humble-learner006/Robomaster-Track-AA-Training-Robot/02-firmware/README.md

Sentry Chassis on Event OS

Debug Log:
1.

Version Control:
1. 2024-05-14 张树涵 Initial version
2. 2024-09-08 张树涵 Remove most unused processes
