humble-learner006/Robomaster-Track-AA-Training-Robot/02-firmware/SEML/Doc/Pictures/DSP/1690799671915.jpg

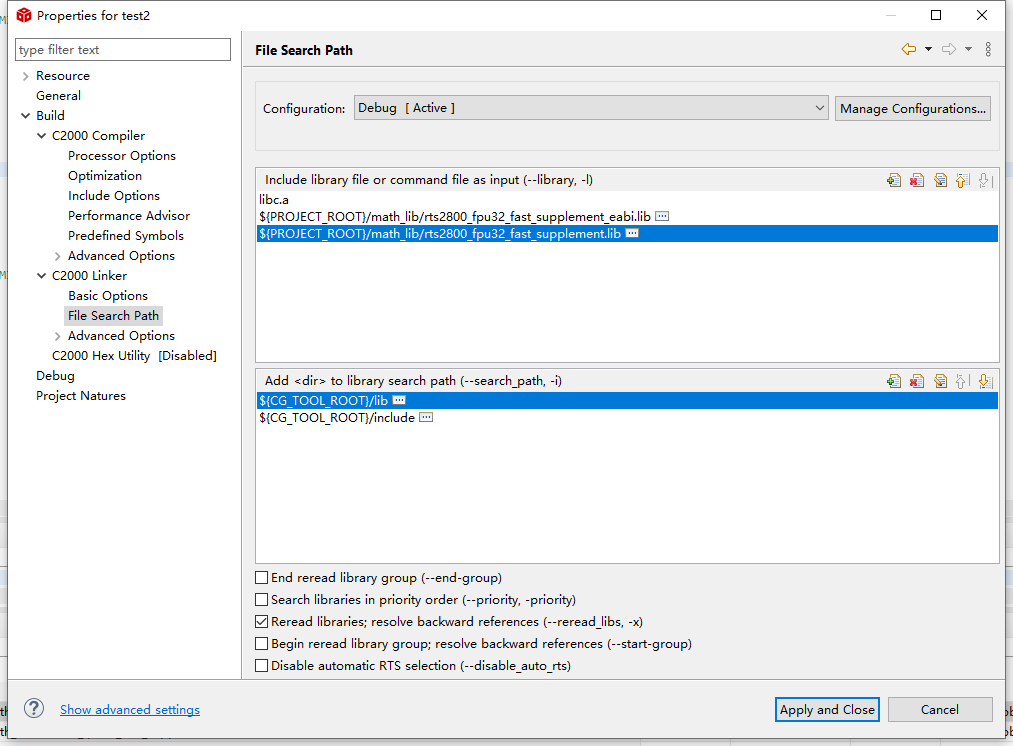
02-firmware/SEML/Doc/Pictures/DSP/1690799671915.jpg
