humble-learner006/Robomaster-Track-AA-Training-Robot/02-firmware/SEML/Doc/Pictures/DSP/1690806582535.jpg

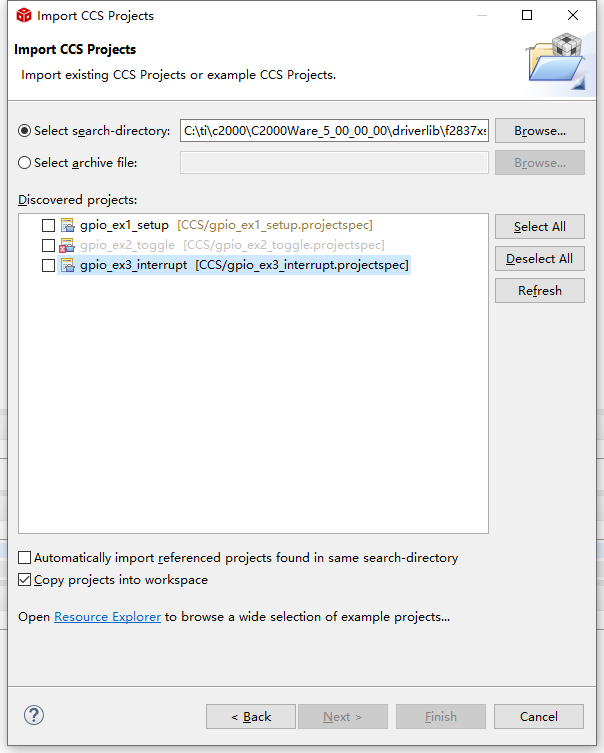
02-firmware/SEML/Doc/Pictures/DSP/1690806582535.jpg
