humble-learner006/Robomaster-Track-AA-Training-Robot/02-firmware/SEML/Doc/Pictures/DSP/1690852160970.jpg

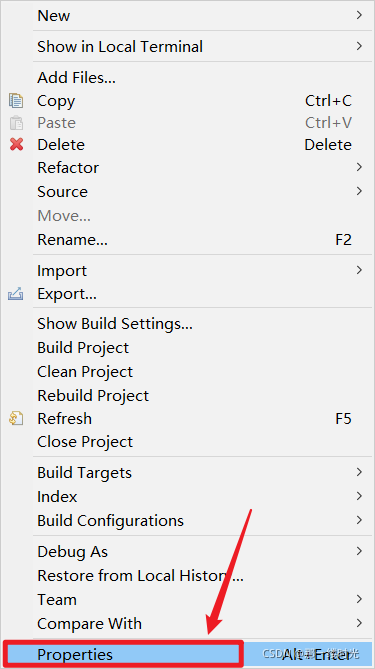
02-firmware/SEML/Doc/Pictures/DSP/1690852160970.jpg
