humble-learner006/Robomaster-Track-AA-Training-Robot/02-firmware/SEML/Doc/Pictures/DSP/image-3.png

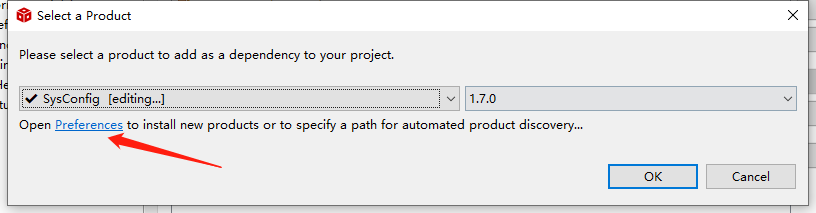
02-firmware/SEML/Doc/Pictures/DSP/image-3.png
