humble-learner006/Robomaster-Track-AA-Training-Robot/02-firmware/SEML/Doc/Pictures/DSP/image-6.png

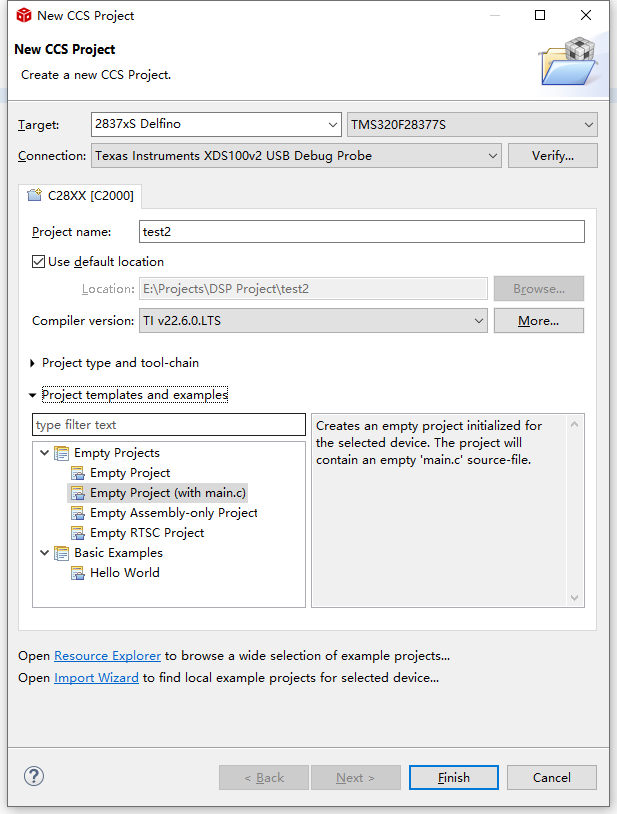
02-firmware/SEML/Doc/Pictures/DSP/image-6.png
