humble-learner006/Robomaster-Track-AA-Training-Robot/02-firmware/SEML/Doc/Pictures/git环境配置/0d65965260c74054983f04c8fb330b49.png

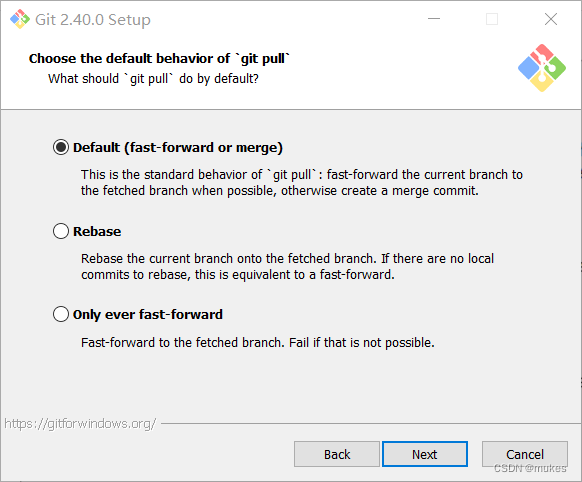
02-firmware/SEML/Doc/Pictures/git环境配置/0d65965260c74054983f04c8fb330b49.png
