humble-learner006/Robomaster-Track-AA-Training-Robot/02-firmware/SEML/Doc/Pictures/git环境配置/0f1968ce5c6a46539ef0dfa324b7ec4c.png

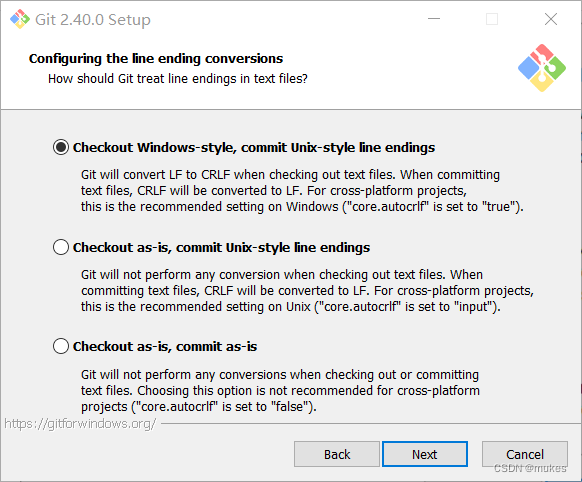
02-firmware/SEML/Doc/Pictures/git环境配置/0f1968ce5c6a46539ef0dfa324b7ec4c.png
