humble-learner006/Robomaster-Track-AA-Training-Robot/02-firmware/SEML/Doc/Pictures/git环境配置/0518f6fa41f6451b864c2c7a0c4c0f17.png

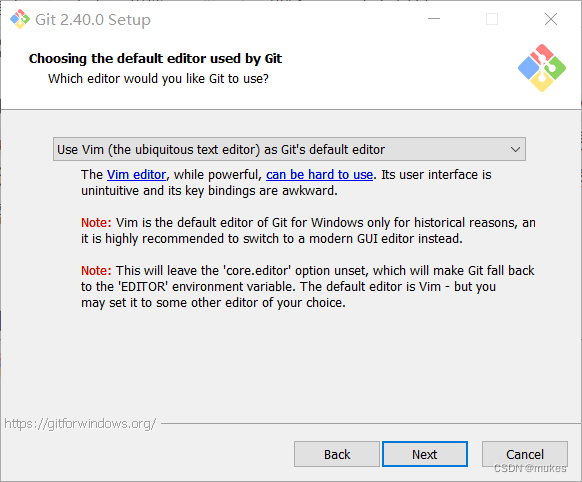
02-firmware/SEML/Doc/Pictures/git环境配置/0518f6fa41f6451b864c2c7a0c4c0f17.png
