humble-learner006/Robomaster-Track-AA-Training-Robot/02-firmware/SEML/Doc/Pictures/git环境配置/5044ca0a1c1a4534a274b0d2df580ec3.png

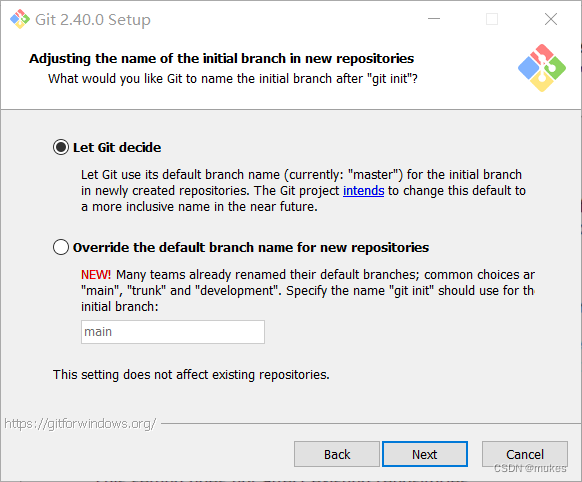
02-firmware/SEML/Doc/Pictures/git环境配置/5044ca0a1c1a4534a274b0d2df580ec3.png
