humble-learner006/Robomaster-Track-AA-Training-Robot/02-firmware/SEML/Doc/Pictures/git环境配置/78469fca81b541c5986913f233740bb5.png

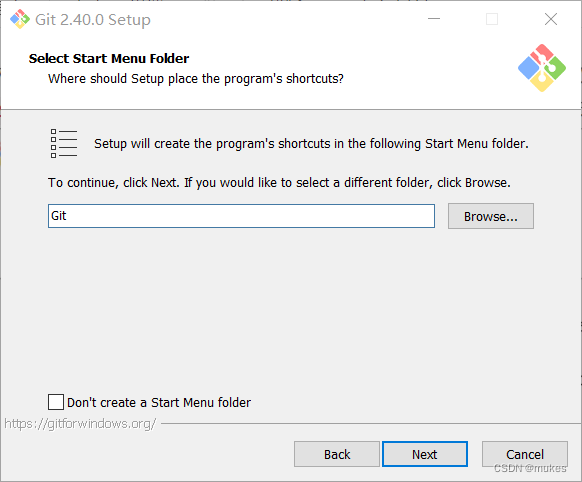
02-firmware/SEML/Doc/Pictures/git环境配置/78469fca81b541c5986913f233740bb5.png
