humble-learner006/Robomaster-Track-AA-Training-Robot/02-firmware/SEML/Doc/Pictures/git环境配置/88422790b5e3410c92eb2bafef00e7fc.png

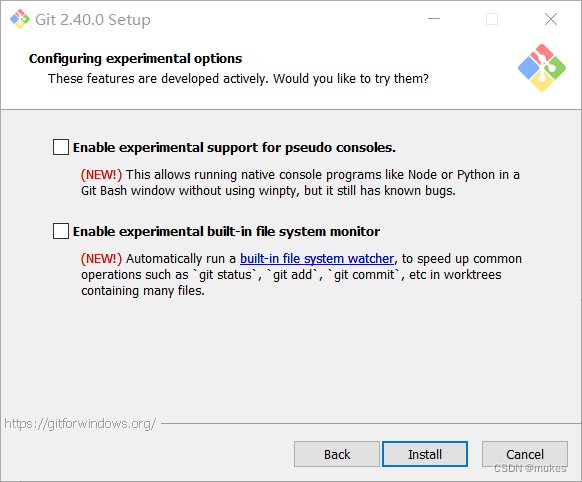
02-firmware/SEML/Doc/Pictures/git环境配置/88422790b5e3410c92eb2bafef00e7fc.png
