humble-learner006/Robomaster-Track-AA-Training-Robot/02-firmware/SEML/Doc/Pictures/git环境配置/01177039343f447ab1c873d59269db94.png

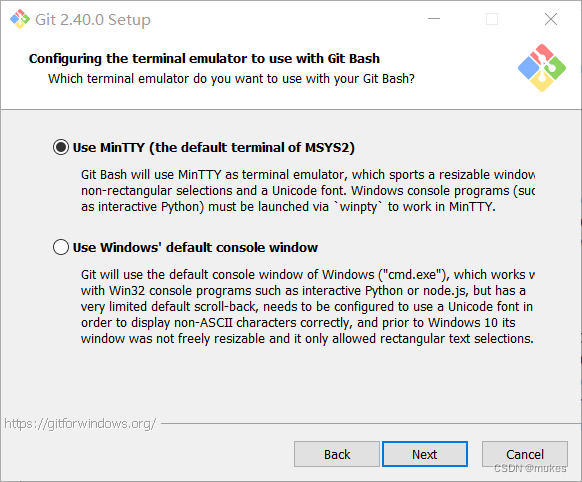
02-firmware/SEML/Doc/Pictures/git环境配置/01177039343f447ab1c873d59269db94.png
