humble-learner006/Robomaster-Track-AA-Training-Robot/02-firmware/SEML/Doc/Pictures/git环境配置/a5128524791d4415b2ee612f6357e90d.png

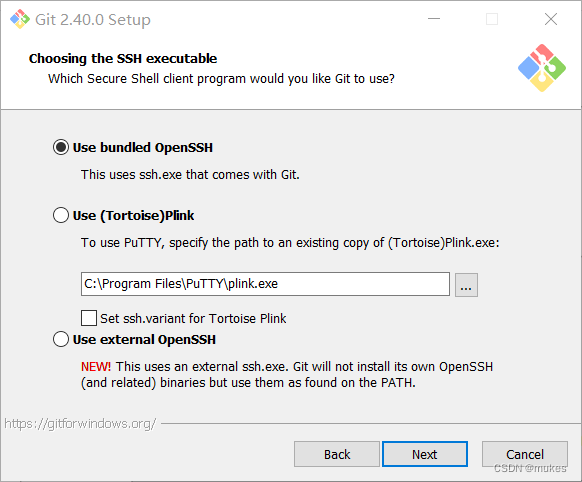
02-firmware/SEML/Doc/Pictures/git环境配置/a5128524791d4415b2ee612f6357e90d.png
