humble-learner006/Robomaster-Track-AA-Training-Robot/02-firmware/SEML/Doc/Pictures/git环境配置/aee056db19ca4412acb5885e3aca9fdb.png

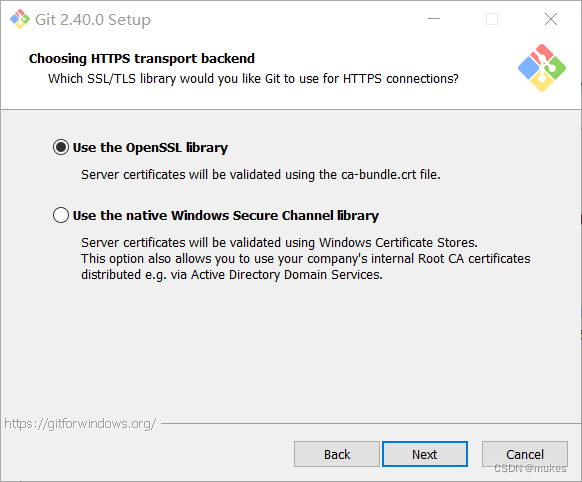
02-firmware/SEML/Doc/Pictures/git环境配置/aee056db19ca4412acb5885e3aca9fdb.png
