humble-learner006/Robomaster-Track-AA-Training-Robot/02-firmware/SEML/Doc/Pictures/git环境配置/b1057c8b5f26494894fa691e84037520.png

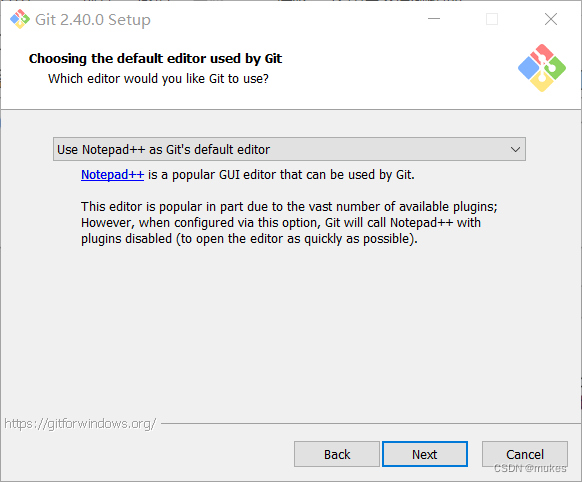
02-firmware/SEML/Doc/Pictures/git环境配置/b1057c8b5f26494894fa691e84037520.png
