humble-learner006/Robomaster-Track-AA-Training-Robot/02-firmware/SEML/Doc/Pictures/git环境配置/bf76981c79714e2586af65fbd48eed01.png

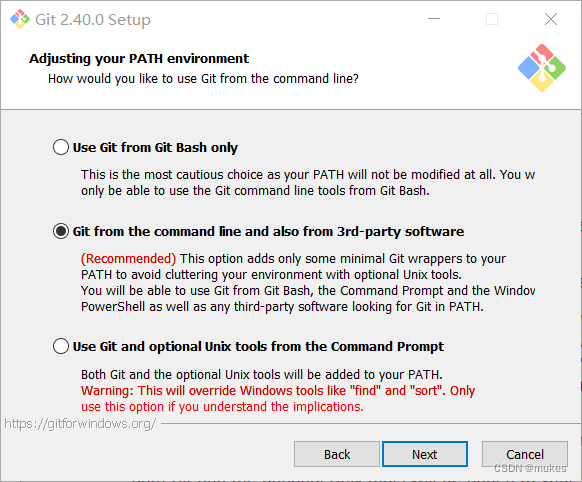
02-firmware/SEML/Doc/Pictures/git环境配置/bf76981c79714e2586af65fbd48eed01.png
