humble-learner006/Robomaster-Track-AA-Training-Robot/02-firmware/SEML/Doc/Pictures/git环境配置/dd6fab0c1ae049729a7df0105c8951f4.png

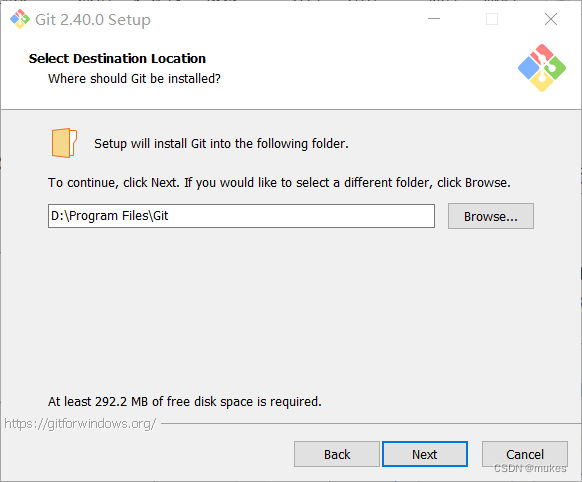
02-firmware/SEML/Doc/Pictures/git环境配置/dd6fab0c1ae049729a7df0105c8951f4.png
