humble-learner006/Robomaster-Track-AA-Training-Robot/02-firmware/SEML/Doc/Pictures/git环境配置/e1bba68d04694d5fb98bc92500a6b013.png

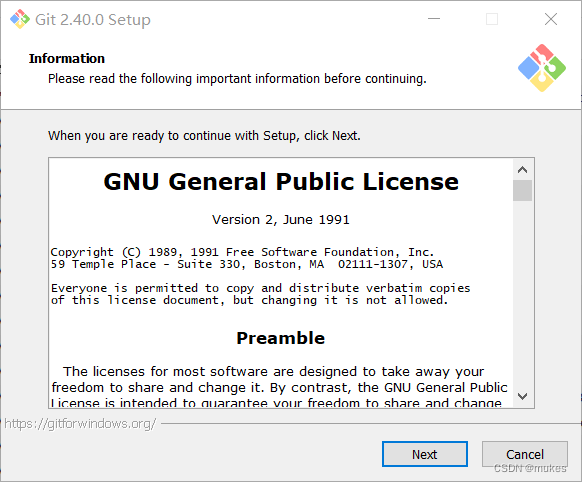
02-firmware/SEML/Doc/Pictures/git环境配置/e1bba68d04694d5fb98bc92500a6b013.png
