humble-learner006/Robomaster-Track-AA-Training-Robot/02-firmware/SEML/Doc/Pictures/git环境配置/f9aee091420b4807b961f48a00afd6f8.png

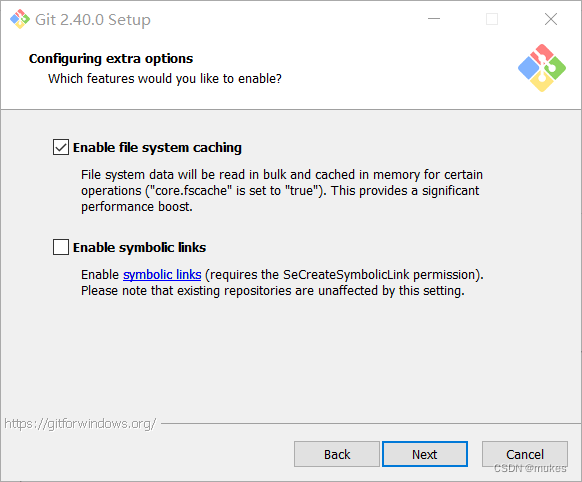
02-firmware/SEML/Doc/Pictures/git环境配置/f9aee091420b4807b961f48a00afd6f8.png
