humble-learner006/Robomaster-Track-AA-Training-Robot/02-firmware/SEML/Doc/Pictures/git环境配置/fe3c254258b84f9a84c0ed40d7a1602d.png

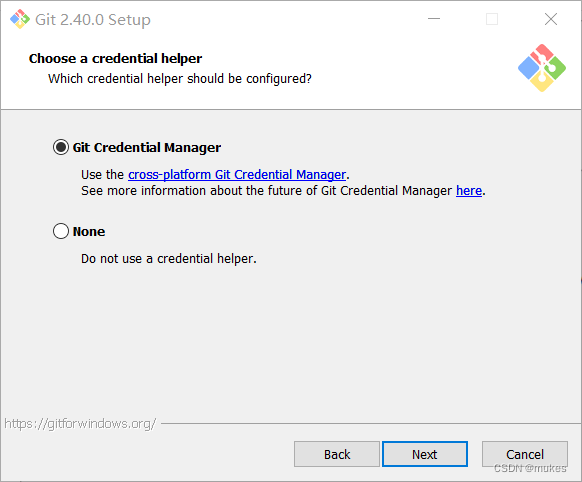
02-firmware/SEML/Doc/Pictures/git环境配置/fe3c254258b84f9a84c0ed40d7a1602d.png
