humble-learner006/Robomaster-Track-AA-Training-Robot/02-firmware/SEML/Doc/Pictures/git环境配置/image-20230907114304048.png

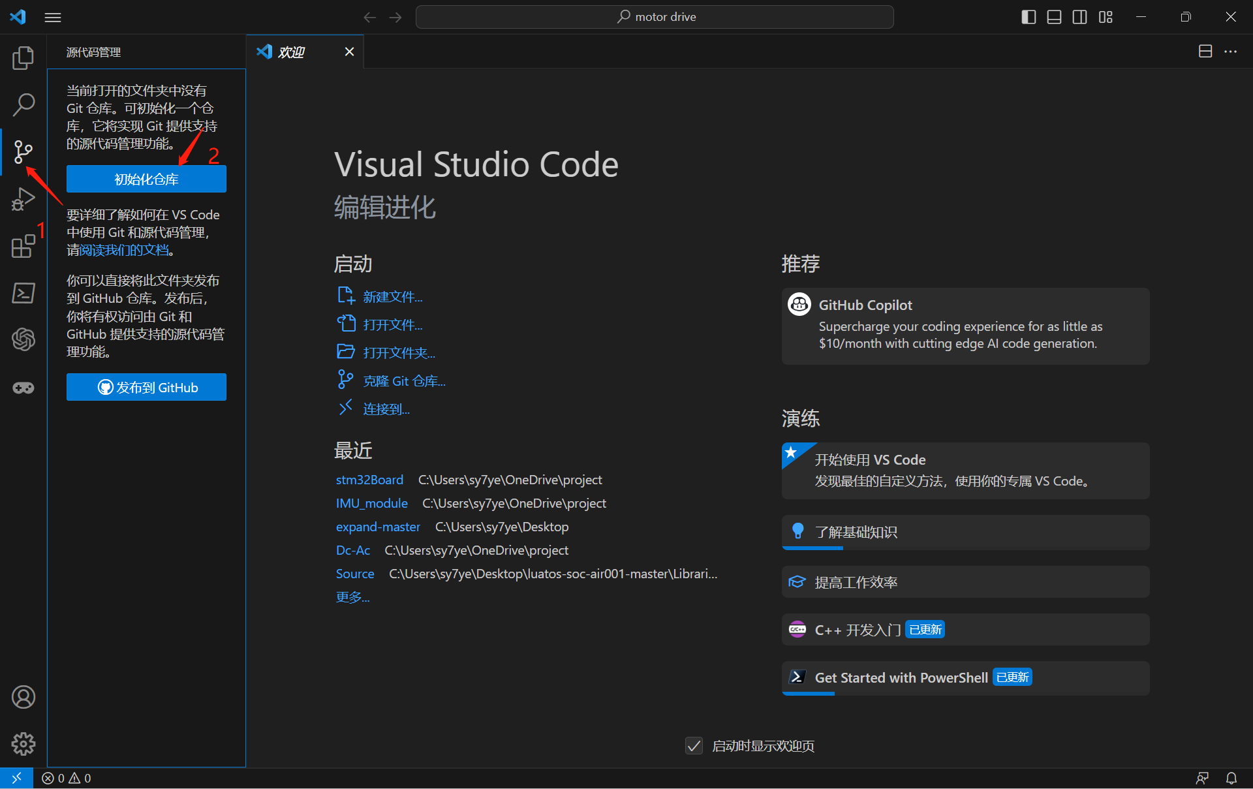
02-firmware/SEML/Doc/Pictures/git环境配置/image-20230907114304048.png
