humble-learner006/Robomaster-Track-AA-Training-Robot/02-firmware/SEML/Doc/Pictures/git环境配置/image-20230919171450884.png

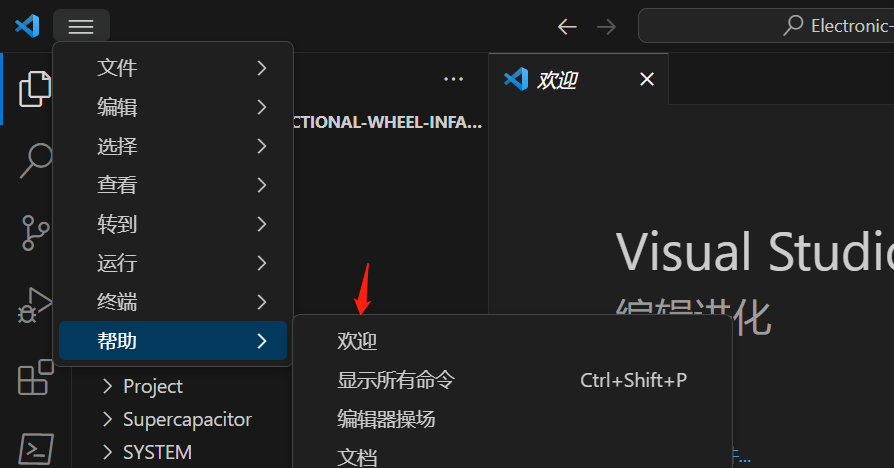
02-firmware/SEML/Doc/Pictures/git环境配置/image-20230919171450884.png
