humble-learner006/Robomaster-Track-AA-Training-Robot/02-firmware/SEML/Doc/Pictures/git环境配置/watermark,type_d3F5LXplbmhlaQ,shadow_50,text_Q1NETiBAbXVrZXM=,size_20,color_FFFFFF,t_70,g_se,x_16-16940544639864.png

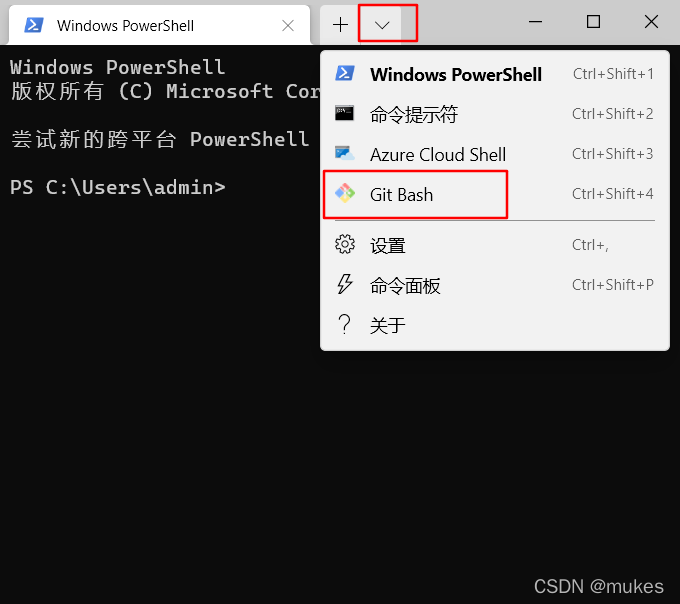
02-firmware/SEML/Doc/Pictures/git环境配置/watermark,type_d3F5LXplbmhlaQ,shadow_50,text_Q1NETiBAbXVrZXM=,size_20,color_FFFFFF,t_70,g_se,x_16-16940544639864.png
