humble-learner006/Robomaster-Track-AA-Training-Robot/02-firmware/SEML/Doc/Pictures/git环境配置/watermark,type_ZmFuZ3poZW5naGVpdGk,shadow_10,text_aHR0cHM6Ly9ibG9nLmNzZG4ubmV0L211a2Vz,size_16,color_FFFFFF,t_70-169405553481018.png

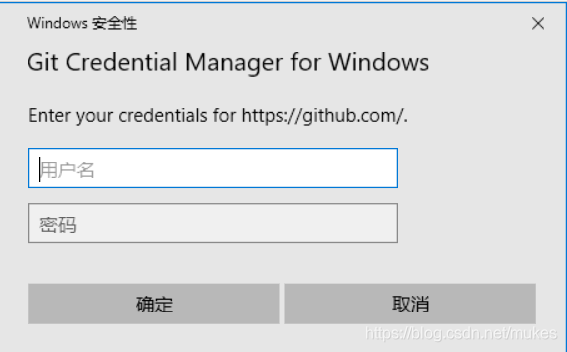
02-firmware/SEML/Doc/Pictures/git环境配置/watermark,type_ZmFuZ3poZW5naGVpdGk,shadow_10,text_aHR0cHM6Ly9ibG9nLmNzZG4ubmV0L211a2Vz,size_16,color_FFFFFF,t_70-169405553481018.png
