humble-learner006/Robomaster-Track-AA-Training-Robot/02-firmware/SEML/Doc/Pictures/README/README1.jpg

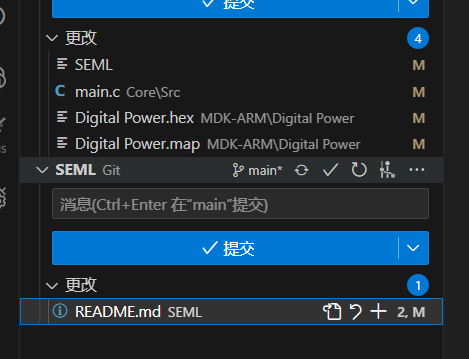
02-firmware/SEML/Doc/Pictures/README/README1.jpg
