humble-learner006/Robomaster-Track-AA-Training-Robot/02-firmware/SEML/Doc/Pictures/VSCode+Ozone使用方法/image-20221119223148604.png

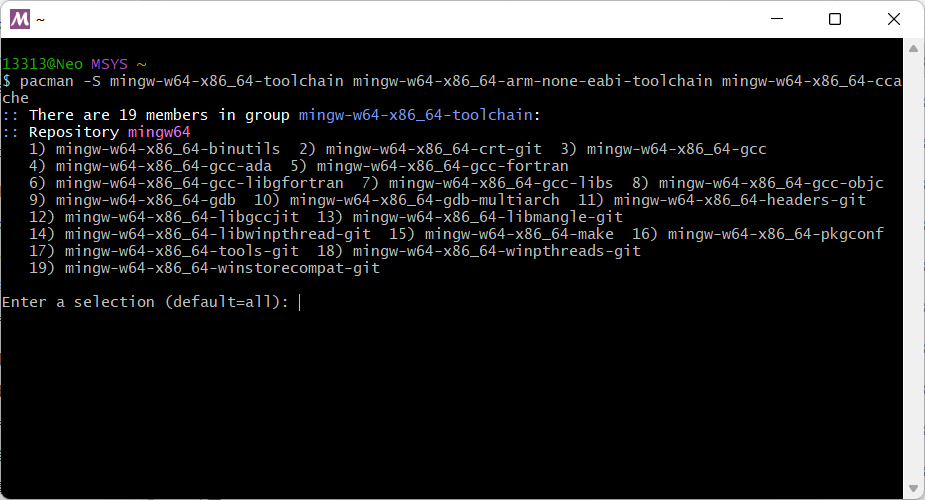
02-firmware/SEML/Doc/Pictures/VSCode+Ozone使用方法/image-20221119223148604.png
