humble-learner006/Robomaster-Track-AA-Training-Robot/02-firmware/SEML/Doc/Pictures/VSCode+Ozone使用方法/image-20221201152530558.png

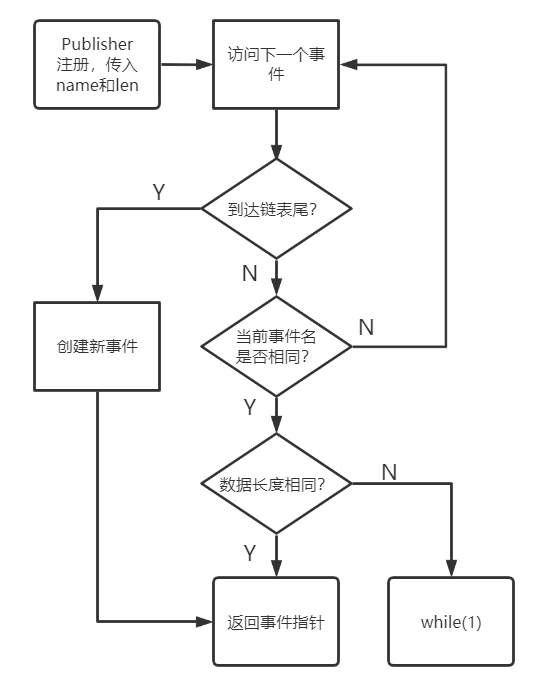
02-firmware/SEML/Doc/Pictures/VSCode+Ozone使用方法/image-20221201152530558.png
