humble-learner006/Robomaster-Track-AA-Training-Robot/02-firmware/SEML/Doc/Pictures/VSCode+Ozone使用方法/v2-2797ea99d0d38eb9996993bb0ad77ab2_720w.webp

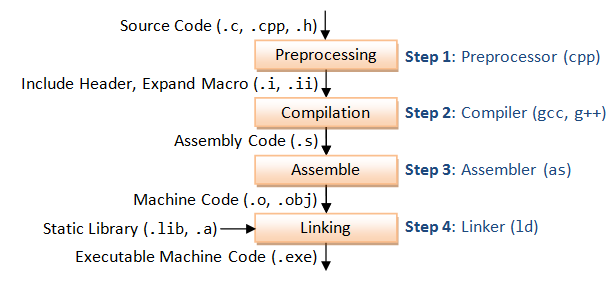
02-firmware/SEML/Doc/Pictures/VSCode+Ozone使用方法/v2-2797ea99d0d38eb9996993bb0ad77ab2_720w.webp
