humble-learner006/Robomaster-Track-AA-Training-Robot/03-docs/Images/3508电机数据.png

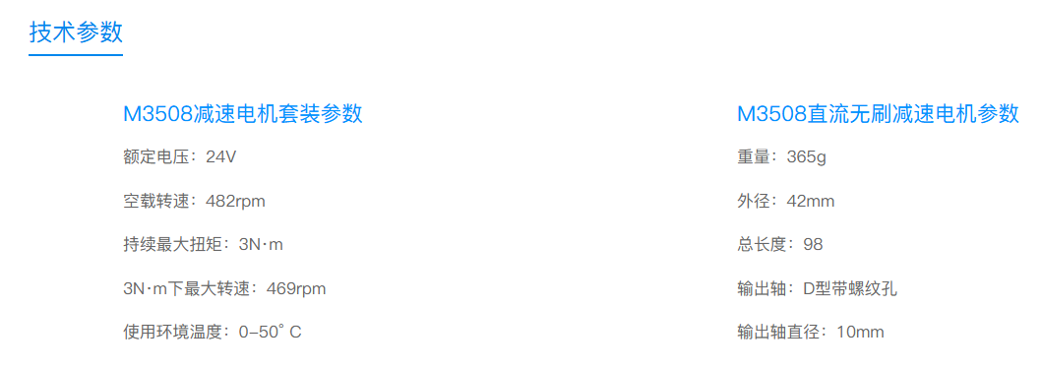
03-docs/Images/3508电机数据.png
