humble-learner006/Robomaster-Track-AA-Training-Robot/03-docs/加工-平动动力轮-6061铝-v3.pdf

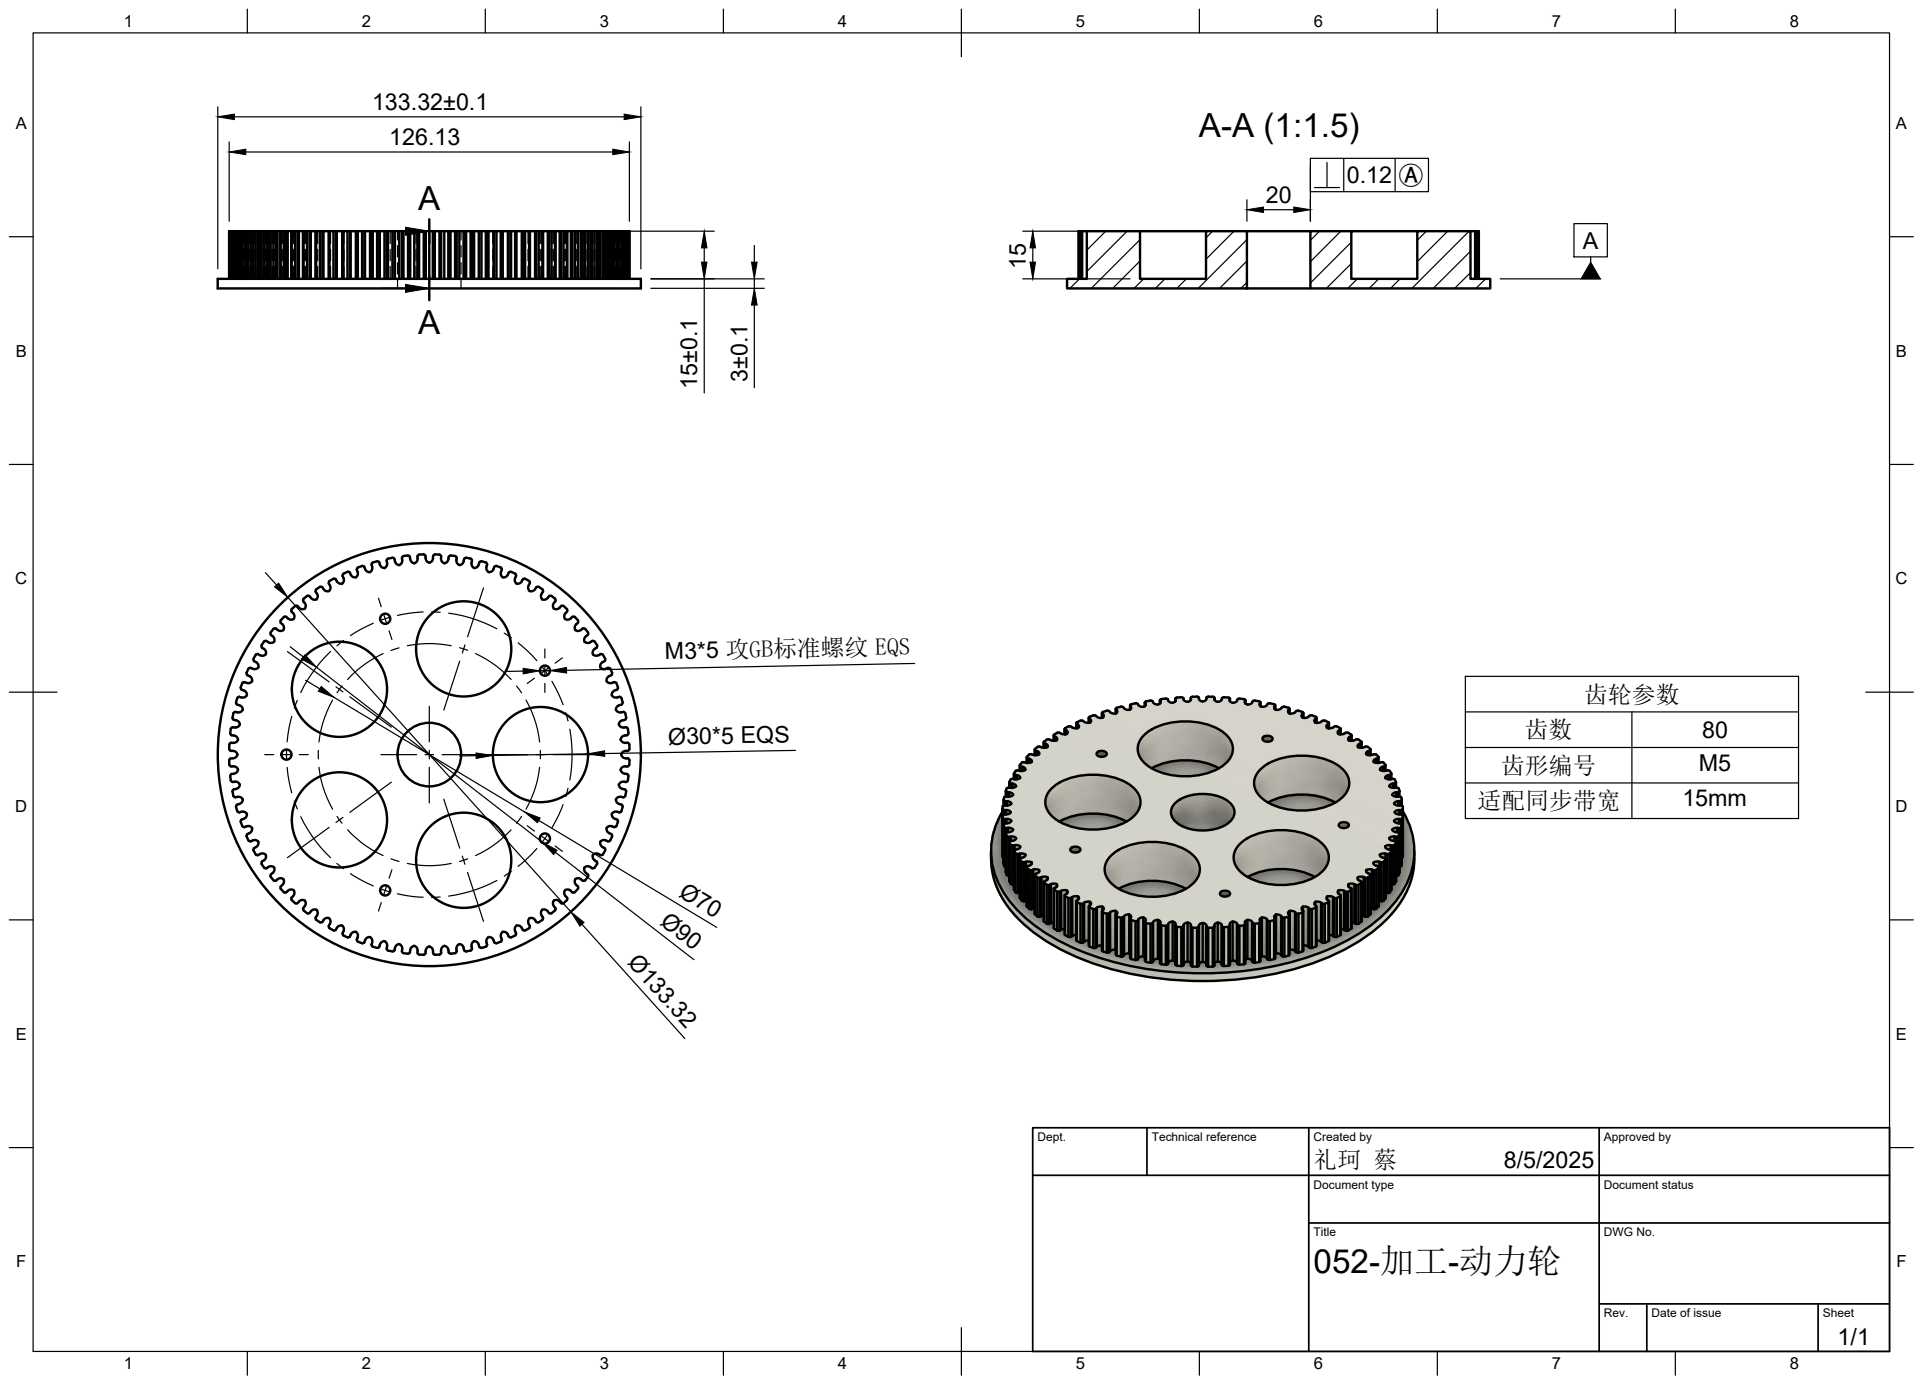
[picture p99: page 1]
Title; DWG No.; Rev.; Date of issue; Sheet; Ø30*5 EQS; M3*5 攻GB标准螺纹 EQS

齿数 | 80
齿形编号 | M5
适配同步带宽 | 15mm

Dept. | Technical reference | Created by 礼珂 蔡 8/5/2025 | Approved by

Document type | Document status
