humble-learner006/Robomaster-Track-AA-Training-Robot/03-docs/加工-旋转从动齿-6061铝.pdf

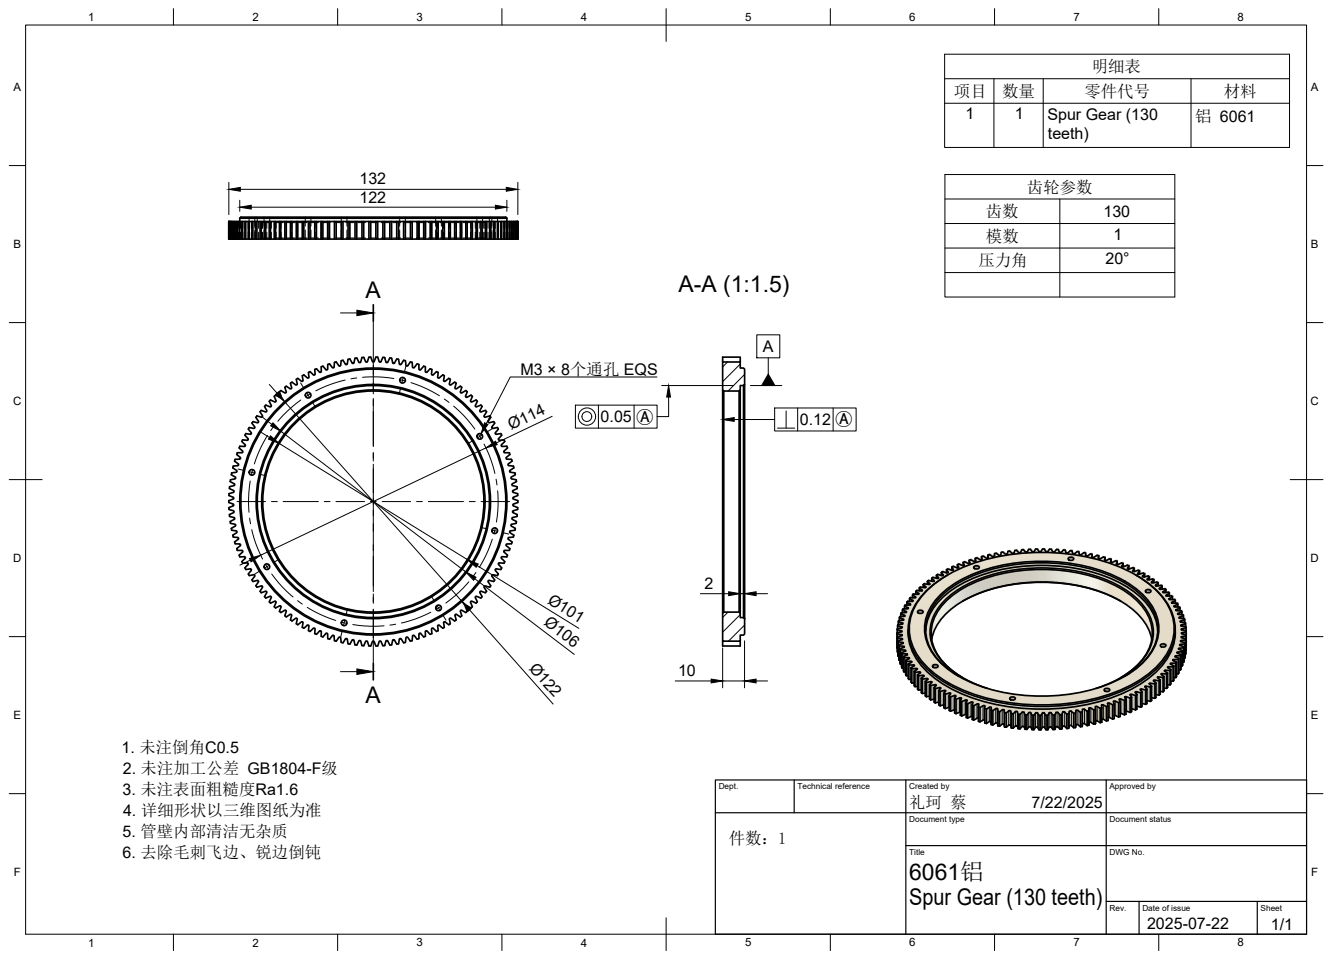
[picture p101: page 1]
Title; DWG No.; Rev.; Date of issue; Sheet; M3 × 8个通孔 EQS; 1. 未注倒角C0.5 2. 未注加工公差 GB1804-F级 3. 未注表面粗糙度Ra1.6 4. 详细形状以三维图纸为准 5. 管壁内部清洁无杂质 6. 去除毛刺飞边、锐边倒钝

项目 | 数量 | 零件代号 | 材料
1 | 1 | Spur Gear (130 teeth) | 铝 6061

齿数 | 130
模数 | 1
压力角 | 20°

Dept. | Technical reference | Created by 礼珂 蔡 7/22/2025 | Approved by

Document type | Document status

Spur Gear (130 teeth)
