humble-learner006/Robomaster-Track-AA-Training-Robot/03-docs/装配说明-样例-3508电机固定座.pdf

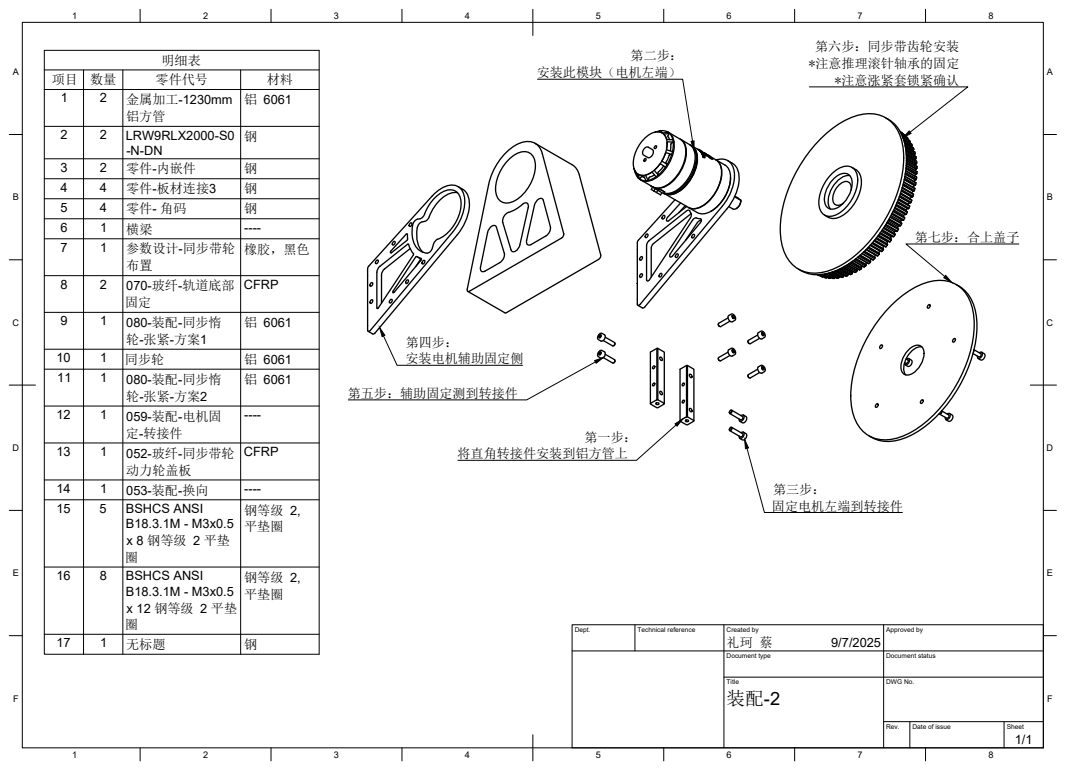
[picture p102: page 1]
Title; DWG No.; Rev.; Date of issue; Sheet

项目 | 数量 | 零件代号 | 材料
1 | 2 | 金属加工-1230mm 铝方管 | 铝 6061

2 | 2 | LRW9RLX2000-S0 -N-DN | 钢

3 | 2 | 零件-内嵌件 | 钢
4 | 4 | 零件-板材连接3 | 钢
5 | 4 | 零件- 角码 | 钢
6 | 1 1 | 参数设计-同步带轮 横梁 | ---- 7

8 | 2 | 070-玻纤-轨道底部 固定 | CFRP

9 | 1 | 080-装配-同步惰 轮-张紧-方案1 | 铝 6061

10 | 1 | 同步轮 | 铝 6061
11 | 1 | 080-装配-同步惰 轮-张紧-方案2 | 铝 6061

12 | 1 1 | 059-装配-电机固 052-玻纤-同步带轮 定-转接件 | ---- 13

动力轮盖板 | CFRP

14 | 5 1 | BSHCS ANSI 053-装配-换向 | ---- 15

B18.3.1M - M3x0.5 x 8 钢等级 2 平垫 圈 | 钢等级 2, 平垫圈

16 | 8 | BSHCS ANSI B18.3.1M - M3x0.5 x 12 钢等级 2 平垫 圈 | 钢等级 2, 平垫圈

Dept. | Technical reference | Created by 礼珂 蔡 9/7/2025 | Approved by

17 | 1 | 无标题 | 钢

Document type | Document status
