humble-learner006/Robomaster-Track-AA-Training-Robot/03-docs/线切割-铝板工图 v4.pdf

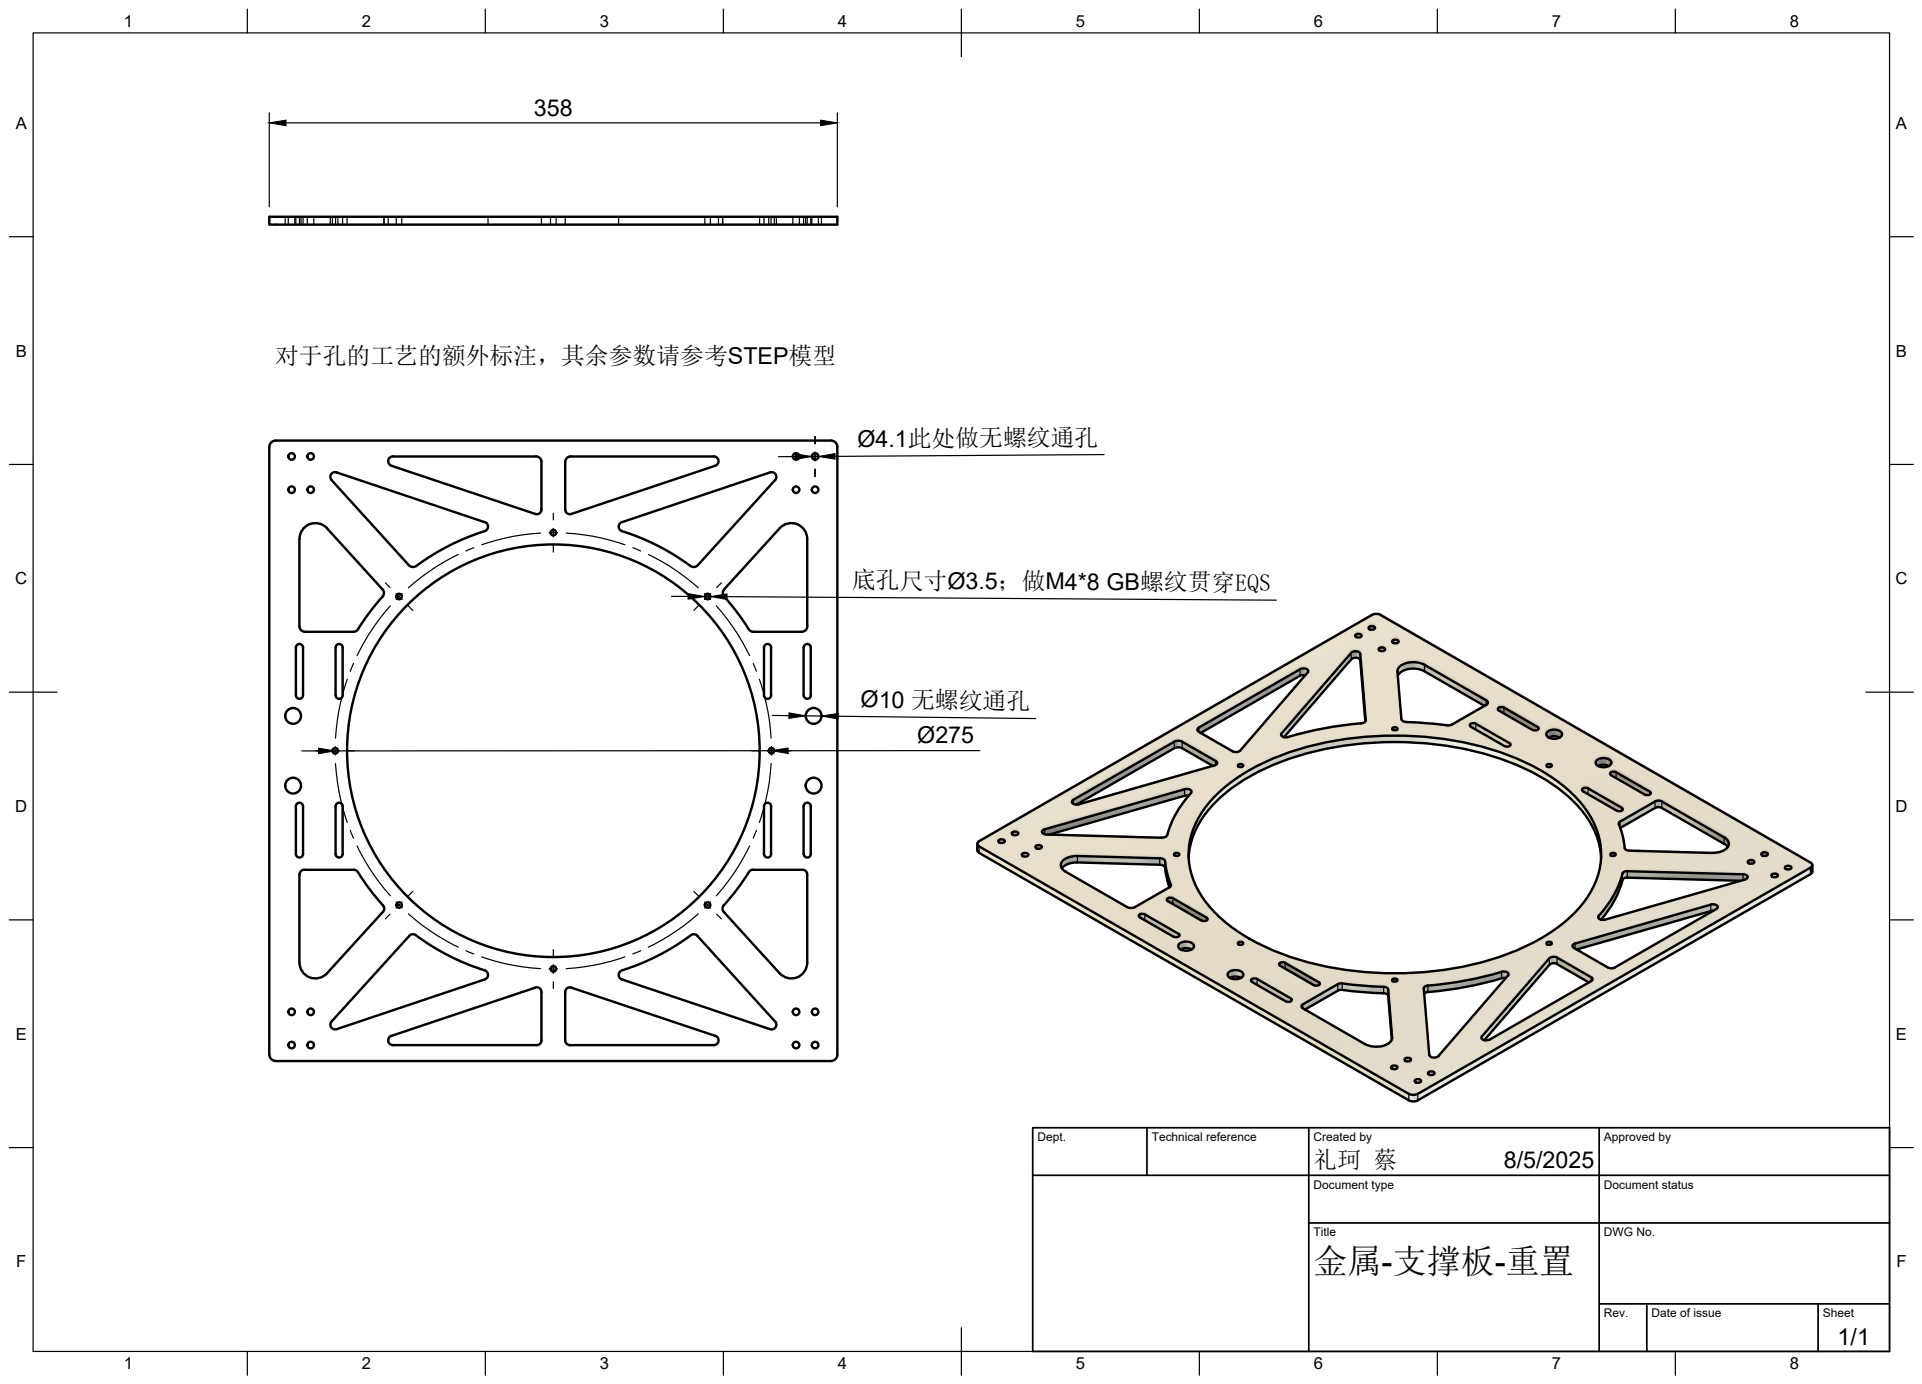
[picture p103: page 1]
Title; DWG No.; Rev.; Date of issue; Sheet; 底孔尺寸Ø3.5；做M4*8 GB螺纹贯穿EQS; Ø10 无螺纹通孔

Dept. | Technical reference | Created by 礼珂 蔡 8/5/2025 | Approved by

Document type | Document status

金属-支撑板-重置
