humble-learner006/Robomaster-Track-AA-Training-Robot/02-firmware/Src/main.c

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
/* Includes ------------------------------------------------------------------*/
#include "main.h"
#include "adc.h"
#include "can.h"
#include "crc.h"
#include "dac.h"
#include "dma.h"
#include "i2c.h"
#include "rng.h"
#include "rtc.h"
#include "spi.h"
#include "tim.h"
#include "usart.h"
#include "usb_device.h"
#include "gpio.h"

/* USER CODE BEGIN Includes */
#include "button.h"
#include "buzzer.h"
#include "can_if.h"
#include "timer.h"
#include "BMI088driver.h"
// #include "ist8310driver.h"
#include "reference.h"
#include "Mahony.h"
#include "WS281x.h"
#include "DR16_Remote.h"
#include "event_os.h"
#include "Robo_Common.h"
#include "Robo_Chassis.h"
#include "Robo_Control.h"
#include "Robo_gimbal.h"
#include "Robo_Shoot.h"
#include "Robo_USB.h"
#include "Robo_AA.h"
/* USER CODE END Includes */

/* USER CODE BEGIN PTD */
// #define Set_LED_R(status) HAL_GPIO_WritePin(LEDR_GPIO_Port, LEDR_Pin, status)
// #define Set_LED_G(status) HAL_GPIO_WritePin(LEDG_GPIO_Port, LEDG_Pin, status)
// #define Set_LED_B(status) HAL_GPIO_WritePin(LEDB_GPIO_Port, LEDB_Pin, status)
// #define Toggle_LED_R() HAL_GPIO_TogglePin(LEDR_GPIO_Port, LEDR_Pin)
// #define Toggle_LED_G() HAL_GPIO_TogglePin(LEDG_GPIO_Port, LEDG_Pin)
// #define Toggle_LED_B() HAL_GPIO_TogglePin(LEDB_GPIO_Port, LEDB_Pin)
/* USER CODE END PTD */

/* USER CODE BEGIN PM */
Soft_Timer_t button_timer, timer_500ms, timer_init;
GPIO_Handle_t key_gpio;
Button_t key;
BMI088_Data_t BMI088;
// ist8310_Handle_t ist8310;
/* pwm 占空比数值为uint16_t 类型，DMA传输时只能以半字输出，pixelBuffer应为uint16_t 类型 */
Buzzer_t buzzer;
WS281x_PWM_Driver_t ws281x_pwm_driver;
WS281x_t *ws281x;
uint16_t ws281x_buffer[1024*GRB];
/* USER CODE END PM */


void SystemClock_Config(void);
/* USER CODE BEGIN PFP */

// void led_G_flash(void *config)
// {
// 	Toggle_LED_G();
// }
// void led_R_flash(void *config)
// {
// 	Toggle_LED_R();
// }
// void led_B_flash(void *config)
// {
// 	Toggle_LED_B();
// }
/* USER CODE END PFP */

/**
  * @brief  The application entry point.
  * @retval int
  */
int main(void)
{
  /* MCU Configuration--------------------------------------------------------*/

  /* Reset of all peripherals, Initializes the Flash interface and the Systick. */
  HAL_Init();

  /* Configure the system clock */
  SystemClock_Config();

  /* Initialize all configured peripherals */
  MX_GPIO_Init();
  MX_DMA_Init();
  MX_ADC1_Init();
  MX_CAN1_Init();
  MX_CAN2_Init();
  MX_SPI1_Init();
  MX_TIM4_Init();
  MX_TIM5_Init();
  MX_USART3_UART_Init();
  MX_RNG_Init();
  MX_RTC_Init();
  MX_TIM1_Init();
  MX_TIM10_Init();
  MX_USART1_UART_Init();
  MX_USART6_UART_Init();
  MX_TIM8_Init();
  MX_I2C2_Init();
  MX_I2C3_Init();
  MX_SPI2_Init();
  MX_CRC_Init();
  MX_DAC_Init();
  MX_USB_DEVICE_Init();
  MX_TIM6_Init();
  MX_TIM7_Init();
  /* USER CODE BEGIN 2 */
	// 初始化按键
	SEML_GPIO_Pin_Register(&key.GPIO_Handle, KEY_GPIO_Port, KEY_Pin);
	Button_Init(&key, RESET);
	// 初始化定时器
	HAL_TIM_RegisterCallback(&htim6, HAL_TIM_PERIOD_ELAPSED_CB_ID, SEML_Timer_Callback);
	HAL_TIM_Base_Start_IT(&htim6);
	// 初始化imu
	SEML_GPIO_Pin_Register(&BMI088.CS1_Accel_handle,CS1_ACCEL_GPIO_Port,CS1_ACCEL_Pin);
	SEML_GPIO_Pin_Register(&BMI088.CS1_Gyro_handle,CS1_GYRO_GPIO_Port,CS1_GYRO_Pin);
	Hardware_SPI_Register(&BMI088.SPI_Handle,&hspi1);
	while(BMI088_Init(&BMI088));
	// 初始化中间件
	Robo_Middleware_Init();
	SEML_Timer_Delete(&timer_init);
	Buzzer_Init(&buzzer,&htim4,TIM_CHANNEL_3,84000000);
	Buzzer_Task_B_B_B(&buzzer,100);
	// 初始化DBUS
	DR16_Init(&RC_Ctrl,&huart3);
	// 初始化事件操作系统
	HAL_TIM_RegisterCallback(&htim7, HAL_TIM_PERIOD_ELAPSED_CB_ID, Event_OS_Callback);
	
	static Event_Task_Handle_t chassis_task_handle,usb_task_handle;
	Event_OS_Task_Register(&chassis_task_handle,1,EOS_High_Priority,Chassis_Init,Chassis_Task,NULL);
	
  Event_OS_Task_Register(&usb_task_handle,1,EOS_High_Priority,USB_Init,USB_Task,NULL);
	HAL_TIM_Base_Start_IT(&htim7);
  /* USER CODE END 2 */

  /* Infinite loop */
  /* USER CODE BEGIN WHILE */
	// 启动定时器
	SEML_Timer_Start(&timer_500ms);
	Buzzer_Task_B_B_B(&buzzer,100);
	// 启动事件操作系统
	Event_OS_Run();
  while (1)
  {
    /* USER CODE END WHILE */
    /* USER CODE BEGIN 3 */
  }
  /* USER CODE END 3 */
}

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
