humble-learner006/Robomaster-Track-AA-Training-Robot/(commit log)

2026-03-25 upload cad and more picture, also better readme update
2026-03-25 update readme and folder name
    [BOM.csv]
2026-03-25 Update README with synchronous belt wheel details
    Added section on synchronous belt wheel support and maintenance issues.
2026-03-25 Update angular velocity range in README
