humble-learner006/Robomaster-Track-AA-Training-Robot/(notices)

Notices in the files:
02-firmware/Src/main.c:
Copyright (c) 2023 STMicroelectronics.
All rights reserved.
This software is licensed under terms that can be found in the LICENSE file
